jcirce/rcc-pico-shield/rcc-pico/rcc-pico-image.jpg

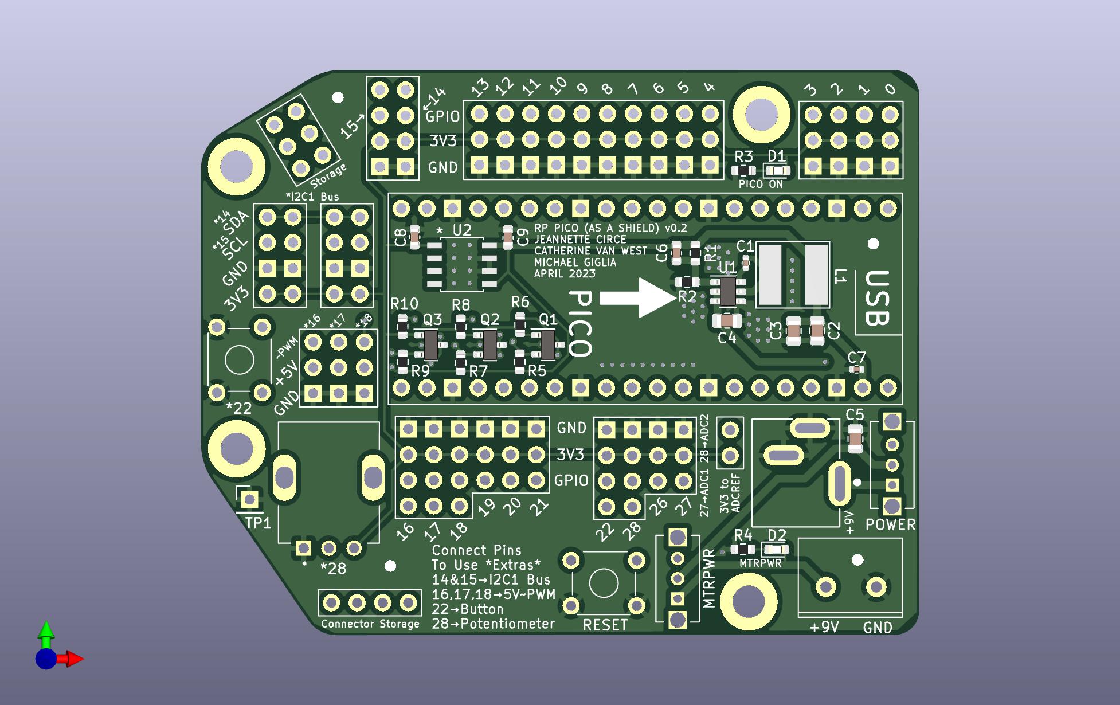
rcc-pico/rcc-pico-image.jpg
