jcirce/rcc-pico-shield/rcc-pico/drawings/rcc-pico-v0.2-invoice.pdf

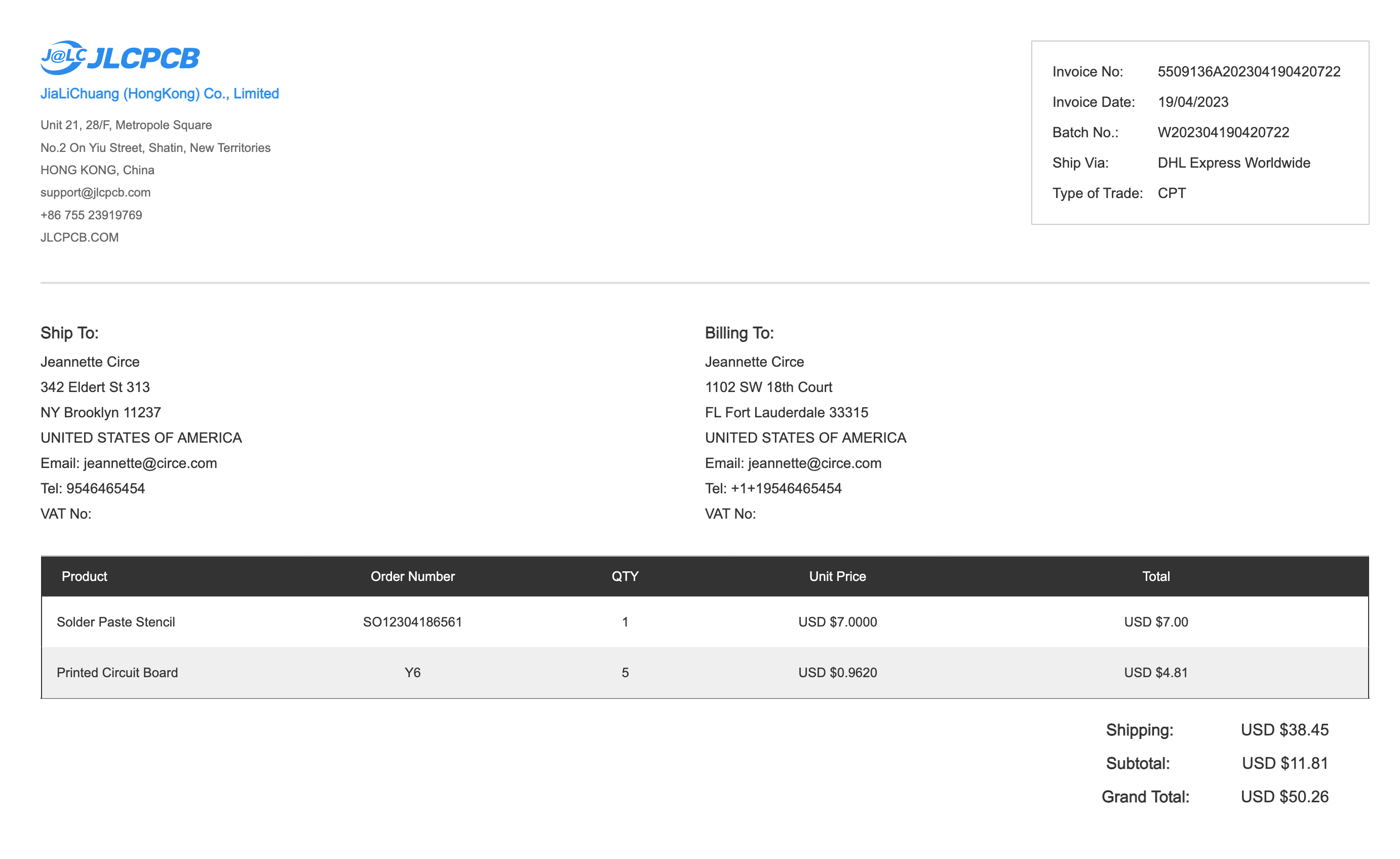
[picture p2: figure]
