jcirce/rcc-pico-shield/rcc-pico/drawings/rcc-pico-v0.1-invoice.pdf

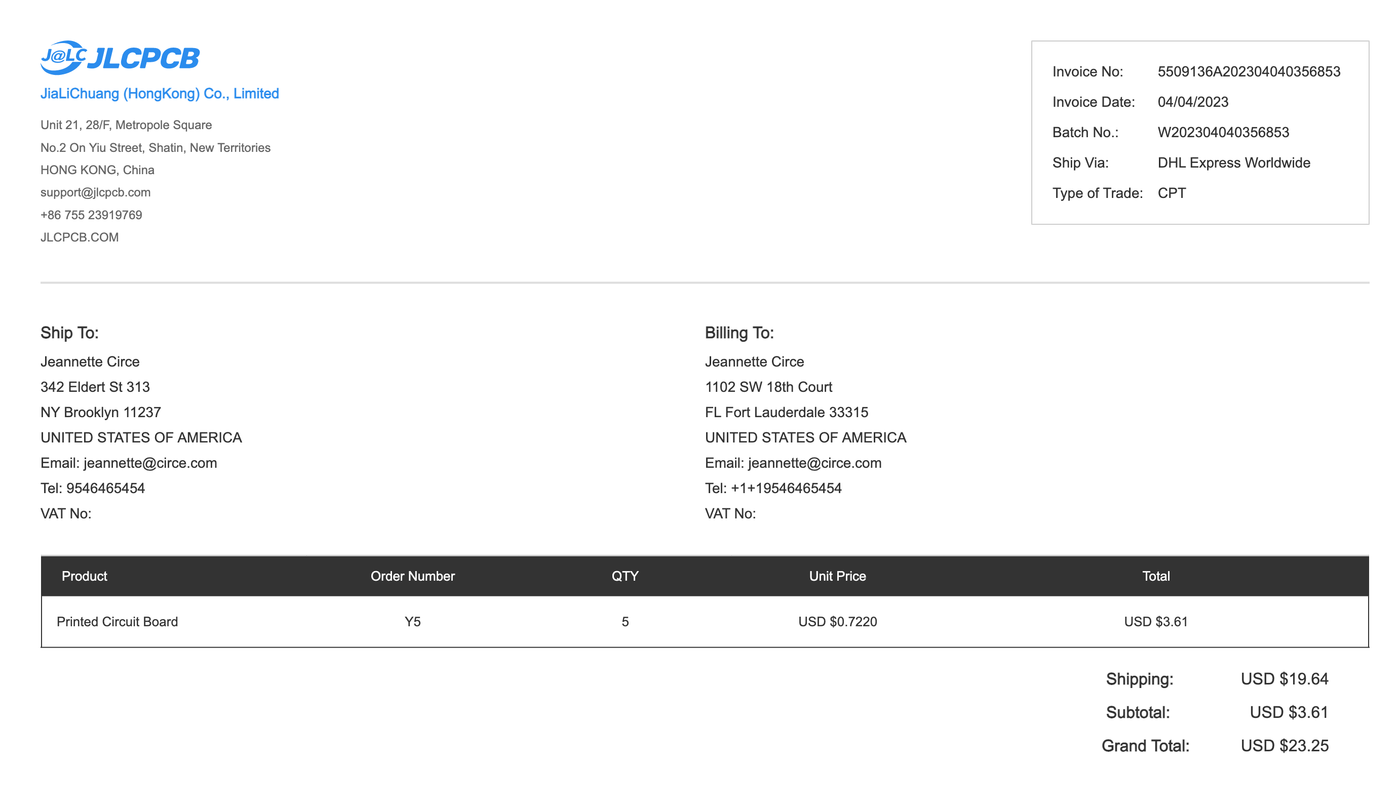
[picture p3: figure]
