jcirce/rcc-pico-shield/v0.2-bom.xlsx

Source: | /Users/jeannettecirce/Desktop/rcc-pico-shield/rcc-pico/rcc-pico.kicad_sch
Date: | 2023 April 18, Tuesday 10:33:05
Tool: | Eeschema 7.0.1-0
Generator: | /Volumes/KiCad/KiCad/KiCad.app/Contents/SharedSupport/plugins/bom_csv_grouped_by_value.py
Component Count: | 51
Collated Components: |  |  |  |  |  | we have | need for 50 boards | need to buy | ordering
Item | Qty | Reference(s) | Value
1 | 2 | C1, C7 | 0.1μ |  | 1276-1043-1-ND (https://www.digikey.com/en/products/detail/samsung-electro-mechanics/CL05A104KA5NNNC/3886701) | 183 | 100 | -83
2 | 2 | C2, C3 | 22μ |  | 1276-1202-1-ND (https://www.digikey.com/en/products/detail/samsung-electro-mechanics/CL21X226MRQNNNE/3886860) | 184 | 100 | -84
3 | 2 | C4, C5 | 10μ |  | 1276-1096-1-ND (https://www.digikey.com/en/products/detail/samsung-electro-mechanics/CL21A106KOQNNNE/3886754) | 184 | 100 | -84
4 | 1 | C6 | 47p |  | 1292-1528-1-ND (https://www.digikey.com/en/products/detail/walsin-technology-corporation/0603N470J500CT/9355025) | 98 | 50 | -48
5 | 2 | C8, C9 | 4.7u |  | 1276-1045-1-ND (https://www.digikey.com/en/products/detail/samsung-electro-mechanics/CL10A475KQ8NNNC/3886703) | 116 | 100 | -16
6 | 2 | D1, D2 | LED |  | 3147-B1911USD-20D000114U1930CT-ND (https://www.digikey.com/en/products/detail/harvatek-corporation/B1911USD-20D000114U1930/15519991) | 89 | 100 | 11 | 20
33 | 1 | D3 | Schottky Diode |  | SX32_R1_00001 | 24 | 50 | 26 | 30
9 | 1 | J3 | PJ-006A |  | CP-006A-ND (https://www.digikey.com/en/products/detail/cui-devices/PJ-006A/269296) | 5 | 50 | 45 | 50
13 | 1 | J8 | Screw_Terminal |  | TC0203620000G-ND (https://www.digikey.com/en/products/detail/amphenol-anytek/TC0203620000G/4940295) | 100 | 50 | -50
20 | 1 | L1 | 4.7u |  | 553-BWVS006060454R7ML1CT-ND (https://www.digikey.com/en/products/detail/pulse-electronics/BWVS006060454R7ML1/12141053) | 25 | 50 | 25 | 25
21 | 3 | Q1, Q2, Q3 | BSS138 | https://www.onsemi.com/pub/Collateral/BSS138-D.PDF | 4530-BSS138CT-ND (https://www.digikey.com/en/products/detail/anbon-semiconductor-int-l-limited/BSS138/16708474) | 85 | 150 | 65 | 100
22 | 1 | R1 | 158k |  | 311-158KHRCT-ND (https://www.digikey.com/en/products/detail/yageo/RC0603FR-07158KL/726963) | 95 | 50 | -45
23 | 1 | R2 | 30.1k |  | 13-RC0603FR-1330K1LCT-ND (https://www.digikey.com/en/products/detail/yageo/RC0603FR-1330K1L/14286407) | 95 | 50 | -45
24 | 1 | R3 | 470 |  | 1292-WR06X471JTLCT-ND (https://www.digikey.com/en/products/detail/walsin-technology-corporation/WR06X471-JTL/13240608) | 95 | 50 | -45
25 | 1 | R4 | 3k |  | 1292-WR06X332JTLCT-ND (https://www.digikey.com/en/products/detail/walsin-technology-corporation/WR06X332-JTL/13241747) | 95 | 50 | -45
26 | 6 | R5, R6, R7, R8, R9, R10 | 10K |  | 1292-WR06X103JTLCT-ND (https://www.digikey.com/en/products/detail/walsin-technology-corporation/WR06X103-JTL/13239132) | 70 | 300 | 230 | 250
27 | 1 | R11 | PT01-D120K2-B103 |  | 2223-PT01-D120K2-B103-ND (https://www.digikey.com/en/products/detail/cui-devices/PT01-D120K2-B103/15903919) | 5 | 50 | 45 | 45
28 | 2 | SW1, SW2 | SW_Push |  | SW402-ND (https://www.digikey.com/en/products/detail/omron-electronics-inc-emc-div/B3F-1020/44059) | 3 | 100 | 97 | 100
29 | 2 | SW-on/off1, SW-on/off2 | SW_SPST |  | CKN9565-ND (https://www.digikey.com/en/products/detail/c-k/OS102011MS2QN1/411602) | 0 | 100 | 100 | 110
31 | 1 | U1 | AP63300WU-7 |  | 31-AP63300WU-7CT-ND (https://www.digikey.com/en/products/detail/diodes-incorporated/AP63300WU-7/10491510) | 4 | 50 | 46 | 50
32 | 1 | U2 | AP2115M-3.3TRG1 |  | AP2115M-3.3TRG1DICT-ND (https://www.digikey.com/en/products/detail/diodes-incorporated/AP2115M-3-3TRG1/5305574) | 8 | 50 | 42 | 50
 |  |  | PicoW |  | SC0918 |  |  | 50
 | 8 |  | Shunts |  | 1849-09200-71-BDGB00-ND (https://www.digikey.com/en/products/detail/metz-connect-usa-inc/09200-71-BDGB00/13536314) | 175 | 400 | 225 | 250
 |  | amazon | Male Headers |  | 30 Pcs 40 pin Breakable Pin Header 2.54mm Single Row Male Header Connector Kit PCB Pin Strip for Arduino (https://www.amazon.com/gp/product/B0817JG3XN/ref=ppx_yo_dt_b_asin_title_o01_s00?ie=UTF8&psc=1) | 10
 |  |  | Female Headers |  | Qunqi 60Pcs 40 Pin 2.54mm Single Row Straight Female PCB Header Connector Strip for Arduino Shield (https://www.amazon.com/gp/product/B07CGGSDWF/ref=ppx_yo_dt_b_asin_title_o00_s00?ie=UTF8&psc=1) | 2
NOT DIGIKEY
30 | 1 | TP1 | TestPoint
33 | 1 | U3 | PicoW
14 | 1 | J10 | Conn_02x04_Odd_Even
15 | 2 | J11, J12 | Conn_02x04_Odd_Even
16 | 1 | J13 | ~
17 | 1 | J14 | Conn_02x05_Odd_Even
18 | 1 | J16 | Conn_01x02_Pin
19 | 1 | J17 | ~
8 | 1 | J1 | Conn_02x02_Odd_Even
7 | 4 | H1, H2, H3, H4 | MountingHole_Pad
10 | 1 | J4 | ~
11 | 1 | J5 | Conn_3x4_female
12 | 1 | J7 | Conn_03x10
