jcirce/rcc-pico-shield/RCC-picoshield-BOM.xlsx

Qty | Reference(s) |  | Value | info | unit price for 50 boards |  |  | 5 boards qnty | going to buy
2 | C1, C2 |  | 10μ | 1276-1096-1-ND (https://www.digikey.com/en/products/detail/samsung-electro-mechanics/CL21A106KOQNNNE/3886754) | $0.03 | $0.07 |  | 10 | 100
2 | C5,C6 |  | 22μ | 1276-2909-1-ND (https://www.digikey.com/en/products/detail/samsung-electro-mechanics/CL21A226MOQNNNE/3888567) | $0.10 | $0.21 |  | 10 | 50
2 | C3,9 |  | 0.1μ | 1276-1004-1-ND (https://www.digikey.com/en/products/detail/samsung-electro-mechanics/CL05F104ZO5NNNC/3886662) | $0.01 | $0.01 |  | 10 | 50
1 | C4 |  | 47p | 732-7764-1-ND (https://www.digikey.com/en/products/detail/w%C3%BCrth-elektronik/885012006021/5453619) | $0.03 | $0.03 |  | 5 | 50
2 | C7,C8 |  | 4.7u | 732-7439-1-ND (https://www.digikey.com/en/products/detail/w%C3%BCrth-elektronik/885012005023/5453294) | $0.01 | $0.03 |  | 10 | 100
1 | D1 |  | LED | LED_SMD:LED_0603_1608Metric |  | $0.00 | ** | 5
1 | J1 | Barrel Jack Input | PJ-006A | 3rdparty:CUI_PJ-006A | $0.82 | $0.82 |  | 5 | 5
1 | J2 | Motor Out | Screw_Terminal | TC0203620000G | $0.19 | $0.19 |  | 5 | 10
1 | L1 |  | 4.7u | BWVS006060454R7ML1 | $0.31 | $0.31 |  | 5 | 10
3 | Q1, Q2, Q3 | Level Shifter FET | BSS138 | 4530-BSS138CT-ND (https://www.digikey.com/en/products/detail/anbon-semiconductor-int-l-limited/BSS138/16708474) | $0.08 | $0.25 |  | 15 | 15
1 | R1 |  | 158k | RC0402FR-07158KL | $0.01 | $0.01 |  | 5 | 10
1 | R2 |  | 30.1k | RC0402FR-0730K1L | $0.01 | $0.01 |  | 5 | 10
6 | R4, R5, R6, R7, R8, R9 |  | 10K | RMCF0402JT10K0 | $0.0045 | $0.03 |  | 30 | 100
1 | R3 |  | 470 | RMCF0402JT470R | $0.0045 | $0.0045 |  | 5 | 100
1 | SW1 | Pico Reset | B3F-1020 | SW402-ND (https://www.digikey.com/en/products/detail/omron-electronics-inc-emc-div/B3F-1020/44059) | $0.35 | $0.35 |  | 5 | 5
2 | SW-on/off1, SW-on/off2 |  |  | 2057-SW-T3-2B-A-A3-S1-ND (https://www.digikey.com/en/products/detail/adam-tech/SW-T3-2B-A-A3-S1/15284416) | $0.76 | $1.51 |  | 10 | 10
1 | U1 | Buck | AP63300WU-7 | 31-AP63300WU-7CT-ND | $0.82 | $0.82 |  | 5 | 5
1 | U2 | LDO | AP2115M-3.3TRG1 | AP2115M-3.3TRG1DICT-ND (https://www.digikey.com/en/products/detail/diodes-incorporated/AP2115M-3-3TRG1/5305574) | $0.30 | $0.30 |  | 5 | 5
5 |  | shunts | 1849-09200-71-BDGB00-ND (https://www.digikey.com/en/products/detail/metz-connect-usa-inc/09200-71-BDGB00/13536314) | 2.54mm 2x1 | $0.03 | $0.14 |  | 25 | 25
1 |  |  |  | potentiometer?? |  | $3.85 | total cost 1 board
 |  |  |  |  |  | $192.54 | total cost 50 boards
 | NO COST
4 | H1, H2, H3, H4 |  | MountingHole_Pad | MountingHole:MountingHole_3.2mm_M3_ISO7380_Pad
1 |  | pico | PicoW | 3rdparty:RPi_Pico_SMD_TH | $6 | $9.85 | with pico
 | Female Headers
2 |  | 20x1 female
 | Headers
1 | TP1 | 1 | TestPoint | Connector_PinHeader_2.54mm:PinHeader_1x01_P2.54mm_Vertical
1 | U3 | 60 | Conn_03x20 | 3rdparty:PinHeader_3x20_P2.54mm_Vertical
1 | J3 | 6 | Conn_02x03_Top_Bottom | Connector_PinHeader_2.54mm:PinHeader_2x03_P2.54mm_Vertical
1 | J4 | 9 | Conn_03x3_female | Connector_PinHeader_2.54mm:PinHeader3x3_P2.54mm_Vertical
1 | J5 | 27 | Conn_03x9 | 3rdparty:PinHeader_3x9_P2.54mm_Vertical
1 | J8 | 16 | Conn_04x4 | Connector_PinHeader_2.54mm:PinHeader4x4_P_2.54mm_Vertical
1 | J9 | 4 | Conn_02x02_Top_Bottom | Connector_PinHeader_2.54mm:PinHeader_2x02_P2.54mm_Vertical
1 | J10 | 9 | Conn_3x3_female | Connector_PinHeader_2.54mm:PinHeader3x3_P2.54mm_Vertical
 |  | 132
 |  |  |  | https://www.amazon.com/Jabinco-Breakable-Header-Connector-Arduino/dp/B0817JG3XN | 6 | $5.73 | $34.38
 |  | header pins |  |  | each box
 |  | yellow | 3V3 | 30
 |  | black | ground | 34 | 200 | 5.882352941
 |  | red | 5V | 3
 |  | white | signal | 26
 |  | blue | 5V signal | 6
 |  | green | I2C | 10
