jcirce/rcc-pico-shield/rcc-pico/drawings/rcc-pico.step

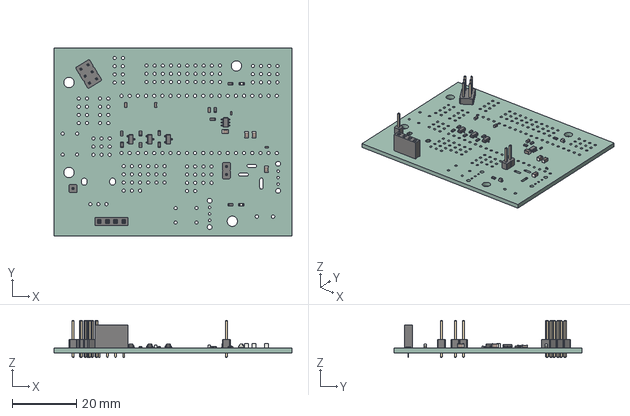
[picture p4: CAD file, 2023-05-04]
rcc-pico/drawings/rcc-pico.step
74.0 x 58.4 x 11.6 mm
PCB
