jcirce/rcc-pico-shield/rcc-pico/drawings/S1M/S1M.step

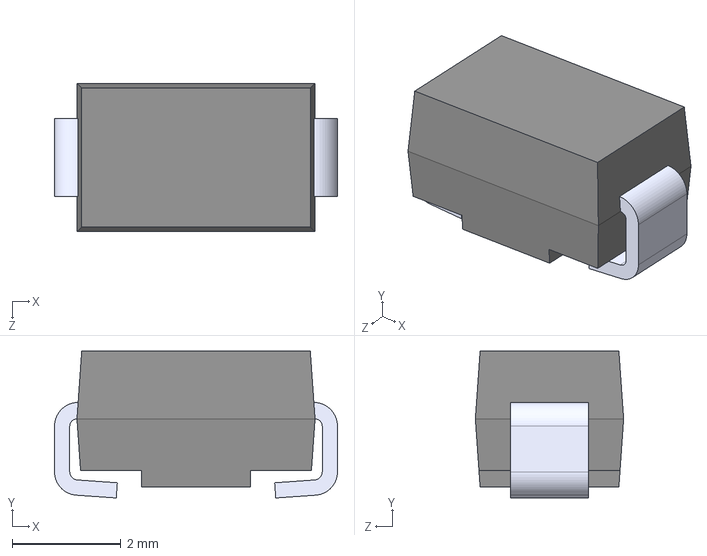
[picture p5: CAD file, 2023-05-04]
rcc-pico/drawings/S1M/S1M.step
5.20 x 2.70 x 2.73 mm
