jcirce/rcc-pico-shield/rcc-pico/OS102011MS2QN1/OS102011MS2QN1.step

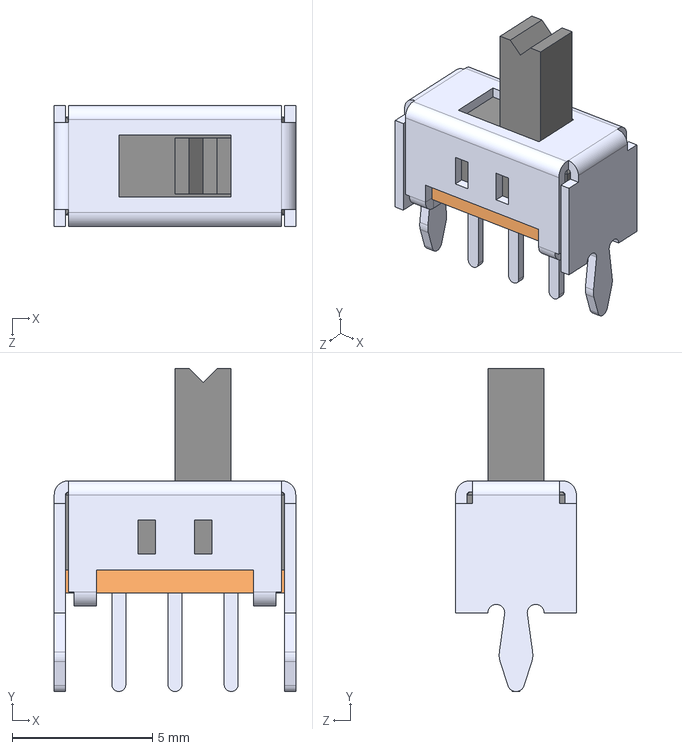
[picture p6: CAD file, 2023-04-18]
rcc-pico/OS102011MS2QN1/OS102011MS2QN1.step
8.60 x 11.5 x 4.30 mm
