jcirce/rcc-pico-shield/rcc-pico/rcc-pico.kicad_pcb

## KiCad design rcc-pico/rcc-pico.kicad_pcb (2023-05-05)

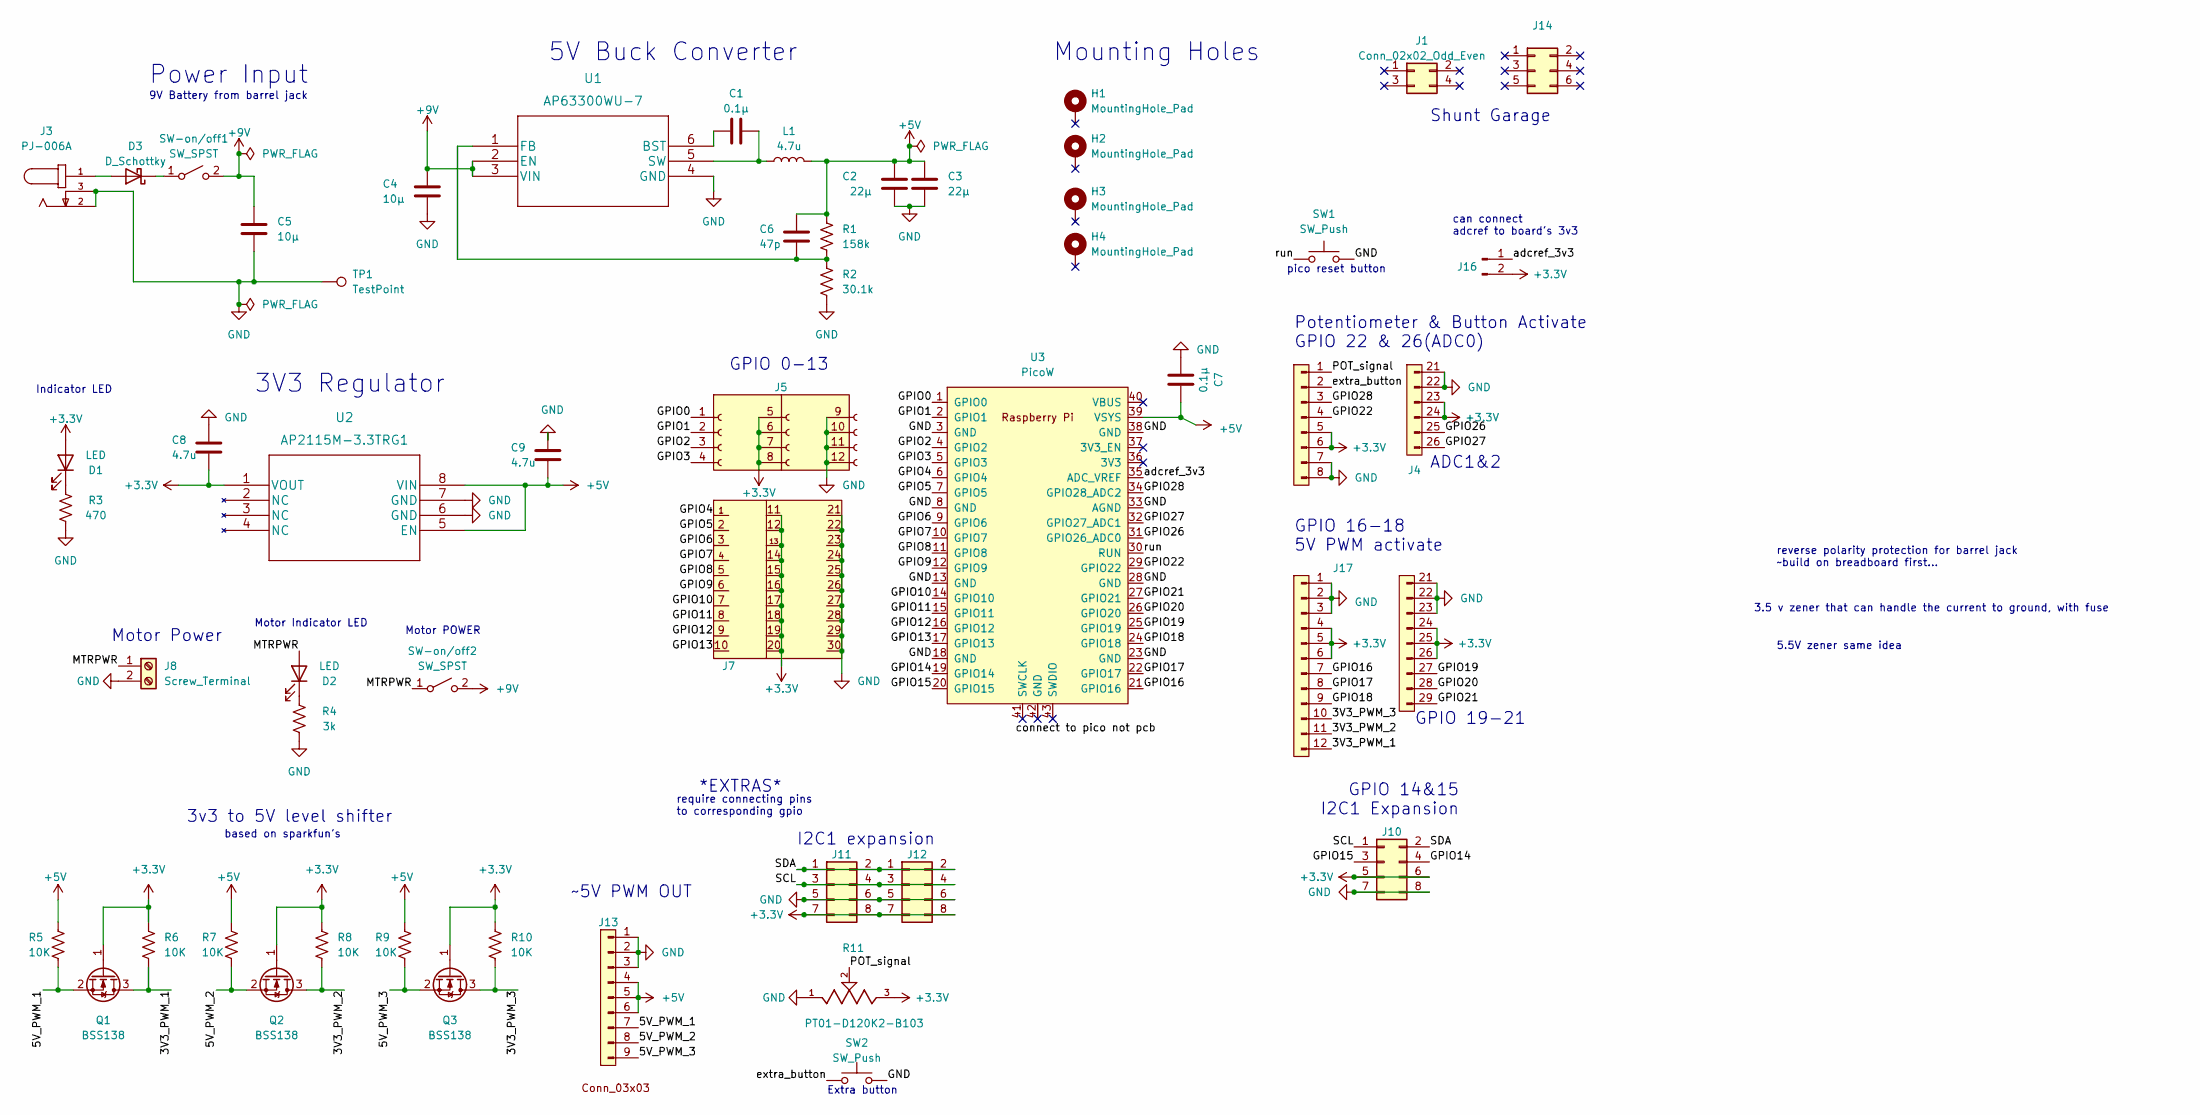
[picture p7: schematic rcc-pico.kicad_sch]

Parts:
C1, C7: 0.1μ; C_0402_1005Metric
C2, C3: 22μ; C_0805_2012Metric
C4, C5: 10μ; C_0805_2012Metric
C6: 47p; C_0603_1608Metric
C8, C9: 4.7u; C_0603_1608Metric
D1, D2: LED; LED_0603_1608Metric
D3: D_Schottky; DIOM5227X270N
H1, H2, H3, H4: MountingHole_Pad; MountingHole_3.2mm_M3_ISO7380_Pad
J1: Conn_02x02_Odd_Even; PinSocket_1x04_P2.54mm_Vertical
J3: PJ-006A; CUI_PJ-006A
J4: Conn_22,24-26
J5: Conn_3x4_female; PinHeader_3x04_P2.54mm_Vertical_gpio
J7: Conn_03x10; PinHeader_3x11_P2.54mm_Vertical
J8: Screw_Terminal; TCxx03_5mm_2x1
J10: Conn_02x04_Odd_Even; PinHeader_2x04_P2.54_Vertical_I2C_shunt
J11, J12: Conn_02x04_Odd_Even; PinHeader_2x04_P2.54_Vertical_I2C
J13: PinHeader_3x03_P2.54mm_Vertical_Servo
J14: Conn_02x05_Odd_Even; PinHeader_2x03_P2.54mm_Vertical
J16: Conn_01x02_Pin; PinHeader_1x02_P2.54mm_Vertical
J17: Conn_16-21
L1: 4.7u; BWVS00606045
Q1, Q2, Q3: BSS138; SOT-23
R1: 158k; R_0603_1608Metric
R2: 30.1k; R_0603_1608Metric
R3: 470; R_0603_1608Metric
R4: 3k; R_0603_1608Metric
R5, R6, R7, R8, R9, R10: 10K; R_0603_1608Metric
R11: PT01-D120K2-B103; TRIM_PT01-D120K2-B103; PARTREV 1.0
SW1, SW2: SW_Push; SW_TH_Tactile_Omron_B3F-10xx
SW-on/off1, SW-on/off2: SW_SPST; SW_OS102011MS2QN1
TP1: TestPoint; PinHeader_1x01_P2.54mm_Vertical
U1: AP63300WU-7; TSOT-23-6
U2: AP2115M-3.3TRG1
U3: PicoW; RPi_Pico_SMD_TH

Connections:
+3.3V: C8.1, D1.2 (A), J4.5, J4.6, J4.23 (Pin_3), J4.24 (Pin_4), J5.5, J5.6, J5.7, J5.8, J7.11, J7.12, J7.13, J7.14, J7.15, J7.16, J7.17, J7.18, J7.19, J7.20, J10.5, J10.6, J11.7, J11.8, J12.7, J12.8, J16.2, J17.4, J17.5, J17.6, J17.24 (Pin_4), J17.25 (5), J17.26 (6), Q1.1 (G), Q2.1 (G), Q3.1 (G), R6.1, R8.1, R10.1, R11.3, U2.1 (VOUT)
+5V: C2.1, C3.1, C6.2, C7.2, C9.1, J13.4, J13.5, J13.6, L1.2, R1.2, R5.1, R7.1, R9.1, U2.5 (EN), U2.8 (VIN), U3.39 (VSYS)
+9V: C4.1, C5.1, SW-on/off1.2 (B), SW-on/off2.2 (B), U1.2 (EN), U1.3 (VIN)
/3V3_PWM_1: J17.12, Q1.3 (D), R6.2
/3V3_PWM_2: J17.11, Q2.3 (D), R8.2
/3V3_PWM_3: J17.10, Q3.3 (D), R10.2
/5V_PWM_1: J13.7, Q1.2 (S), R5.2
/5V_PWM_2: J13.8, Q2.2 (S), R7.2
/5V_PWM_3: J13.9, Q3.2 (S), R9.2
/GPIO0: J5.1, U3.1 (GPIO0)
/GPIO1: J5.2, U3.2 (GPIO1)
/GPIO2: J5.3, U3.4 (GPIO2)
/GPIO3: J5.4, U3.5 (GPIO3)
/GPIO4: J7.1, U3.6 (GPIO4)
/GPIO5: J7.2, U3.7 (GPIO5)
/GPIO6: J7.3, U3.9 (GPIO6)
/GPIO7: J7.4, U3.10 (GPIO7)
/GPIO8: J7.5, U3.11 (GPIO8)
/GPIO9: J7.6, U3.12 (GPIO9)
/GPIO10: J7.7, U3.14 (GPIO10)
/GPIO11: J7.8, U3.15 (GPIO11)
/GPIO12: J7.9, U3.16 (GPIO12)
/GPIO13: J7.10, U3.17 (GPIO13)
/GPIO14: J10.4, U3.19 (GPIO14)
/GPIO15: J10.3, U3.20 (GPIO15)
/GPIO16: J17.7, U3.21 (GPIO16)
/GPIO17: J17.8, U3.22 (GPIO17)
/GPIO18: J17.9, U3.24 (GPIO18)
/GPIO19: J17.27 (7), U3.25 (GPIO19)
/GPIO20: J17.28 (8), U3.26 (GPIO20)
/GPIO21: J17.29 (9), U3.27 (GPIO21)
/GPIO22: J4.4, U3.29 (GPIO22)
/GPIO26: J4.25 (5), U3.31 (GPIO26_ADC0)
/GPIO27: J4.26 (6), U3.32 (GPIO27_ADC1)
/GPIO28: J4.3, U3.34 (GPIO28_ADC2)
/MTRPWR: D2.2 (A), J8.1, SW-on/off2.1 (A)
/POT_signal: J4.1, R11.2
/SCL: J10.1, J11.3, J11.4, J12.3, J12.4
/SDA: J10.2, J11.1, J11.2, J12.1, J12.2
/adcref_3v3: J16.1, U3.35 (ADC_VREF)
/extra_button: J4.2, SW2.1
/run: SW1.1, U3.30 (RUN)
GND: C2.2, C3.2, C4.2, C5.2, C7.1, C8.2, C9.2, J3.2, J3.3, J4.7, J4.8, J4.21 (Pin_1), J4.22 (Pin_2), J5.9, J5.10, J5.11, J5.12, J7.21, J7.22, J7.23, J7.24, J7.25, J7.26, J7.27, J7.28, J7.29, J7.30, J8.2, J10.7, J10.8, J11.5, J11.6, J12.5, J12.6, J13.1, J13.2, J13.3, J17.1, J17.2, J17.3, J17.21 (Pin_1), J17.22 (Pin_2), J17.23 (Pin_3), R2.2, R3.2, R4.2, R11.1, SW1.2, SW2.2, TP1.1, U1.4 (GND), U2.6 (GND), U2.7 (GND), U3.3 (GND), U3.8 (GND), U3.13 (GND), U3.18 (GND), U3.23 (GND), U3.28 (GND), U3.33 (AGND), U3.38 (GND)
unnamed: D1.1 (K), R3.1
unnamed: D2.1 (K), R4.1
unnamed: D3.2 (A), J3.1
unnamed: D3.1 (K), SW-on/off1.1 (A)
unnamed: C1.1, U1.6 (BST)
unnamed: C6.1, R1.1, R2.1, U1.1 (FB)
unnamed: C1.2, L1.1, U1.5 (SW)

Notes on the sheet:
require connecting pins to corresponding gpio
5.5V zener same idea
Mounting Holes
GPIO 16-18 5V PWM activate
GPIO 19-21
I2C1 expansion
reverse polarity protection for barrel jack ~build on breadboard first...
3V3 Regulator
3v3 to 5V level shifter
can connect adcref to board's 3v3
~5V PWM OUT
Extra button
Potentiometer & Button Activate GPIO 22 & 26(ADC0)
Power Input
based on sparkfun's
pico reset button
Motor Power
5V Buck Converter
ADC1&2
9V Battery from barrel jack
3.5 v zener that can handle the current to ground, with fuse
Shunt Garage
GPIO 0-13
Indicator LED
Motor Indicator LED
Motor POWER
*EXTRAS*
GPIO 14&15 I2C1 Expansion

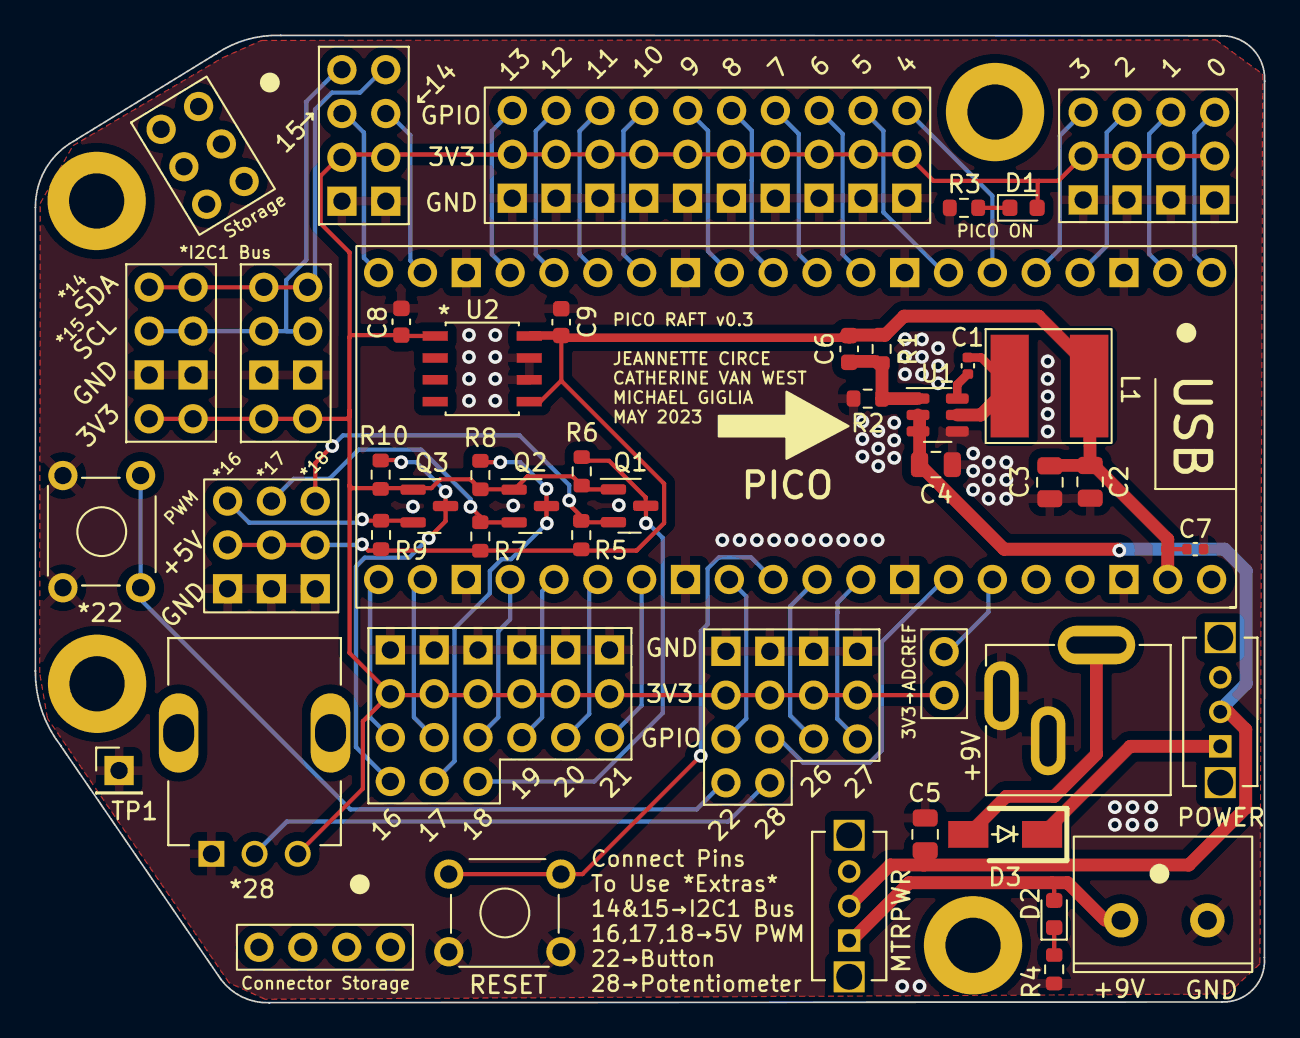
[picture p8: board rcc-pico.kicad_pcb from above]

Board: 2 copper layers, 71.2 x 56.0 mm, 52 parts (0 on the bottom side), 50 nets.
