jcirce/rcc-pico-shield/(commit log)

2023-03-29 first version of rcc-pico shield pcb
    [rcc-pico.kicad_pcb, rcc-pico.kicad_sch]
2023-03-31 new schematic with LDO
    [rcc-pico.kicad_sch]
2023-04-01 finished schematic
    [rcc-pico.kicad_pcb, rcc-pico.kicad_sch]
2023-04-03 finished schematic and layout
    [rcc-pico.csv, rcc-pico.kicad_pcb, rcc-pico.kicad_sch]
2023-04-03 first layout of traces
    [rcc-pico.kicad_pcb]
2023-04-03 ordered JLC
    [2023-04-02T190943.csv, rcc-pico.kicad_pcb, rcc-pico.kicad_sch]
2023-04-03 adding BOM
    [RCC-picoshield-BOM.xlsx]
2023-04-15 new schematic
    [rcc-pico.kicad_pcb, rcc-pico.kicad_sch]
2023-04-15 new layout and screenprint
    [rcc-pico.kicad_pcb, rcc-pico.kicad_sch]
2023-04-18 finished traces for v0.2
    [OS102011MS2QN1.step, rcc-pico.kicad_pcb, rcc-pico.kicad_sch]
2023-04-18 finished DRC, added fiducals and name, cleaned up schematic a bit, still needs some work
    [rcc-pico.kicad_pcb, rcc-pico.kicad_sch]
2023-04-18 fixed D2 footprint
    [rcc-pico.csv, rcc-pico.kicad_pcb, rcc-pico.kicad_sch]
2023-04-18 final touches, fixed footprints
    [rcc-pico.csv, rcc-pico.kicad_pcb, rcc-pico.kicad_sch]
2023-04-18 changed 0.1uH footprint, added v0.2 BOM
    [rcc-pico.kicad_pcb, rcc-pico.kicad_sch, v0.2-bom.xlsx]
2023-04-18 ordering v0.2
    [rcc-pico.kicad_pcb, rcc-pico.kicad_sch]
2023-05-04 v0.3 modifications, added input protection diode
    [2023-04-02T190943.csv, S1M.step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]
2023-05-05 v0.3 for ordering, cleaned up screenprint and rearranged 9v cap to be next to the diode for ease
    [rcc-pico-B_Adhesive.gbr, rcc-pico-B_Cu.gbr, rcc-pico-B_Mask.gbr, rcc-pico-B_Paste.gbr, rcc-pico-B_Silkscreen.gbr, rcc-pico-Edge_Cuts.gbr, rcc-pico-F_Adhesive.gbr, rcc-pico-F_Cu.gbr]
2023-05-05 new bill of materials with orders for 50 boards based on what we have in stock already
    [v0.2-bom.xlsx]
2023-05-05 updated bom
    [v0.2-bom.xlsx]
